miraclewhite-tech/armdojo-hardware/software/README.md

# Software (coming soon)

We are writing the control code for the ArmDojo 5-axis arm on our own assembled arm. It will be published here, with its own open-source license.

Join the discussion on [Discord](https://discord.gg/MdyRuJVFAm) in the `#software-control` channel.
