miraclewhite-tech/armdojo-hardware/arm-r5b/images/renders/hero_01_reach_camera.jpg

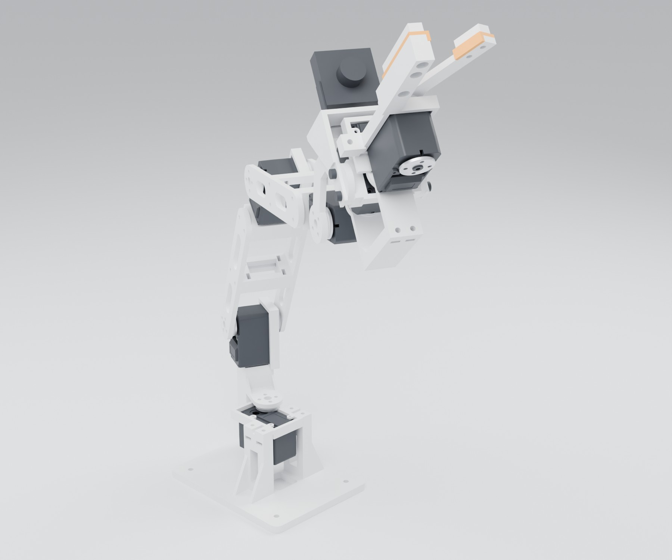
arm-r5b/images/renders/hero_01_reach_camera.jpg
