miraclewhite-tech/armdojo-hardware/arm-r5b/images/renders/hero_03_upright_side.jpg

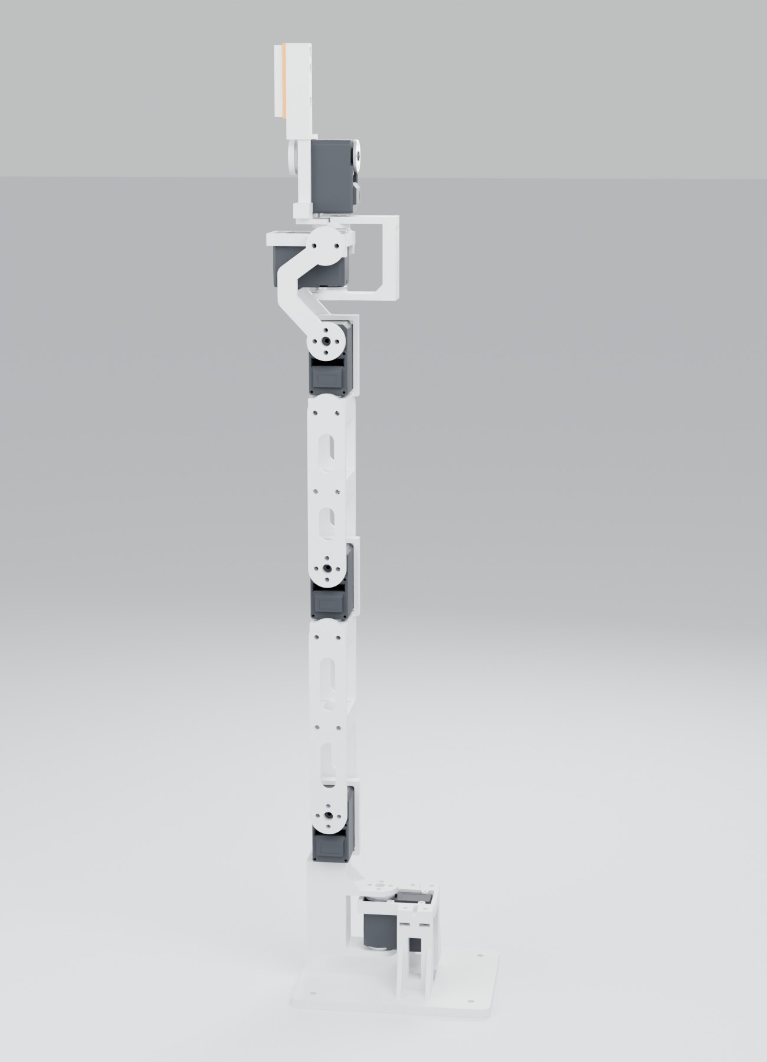
arm-r5b/images/renders/hero_03_upright_side.jpg
