miraclewhite-tech/armdojo-hardware/arm-r5b/images/renders/hero_04_folded.jpg

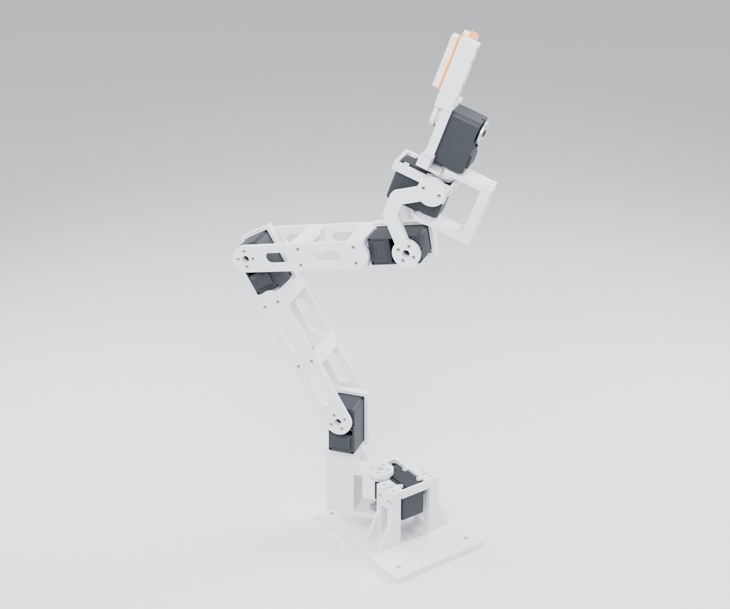
arm-r5b/images/renders/hero_04_folded.jpg
