miraclewhite-tech/armdojo-hardware/arm-r5b/print-profile/ArmDojo_5axis_arm_A1_0.4mm_PLA_TPU.3mf

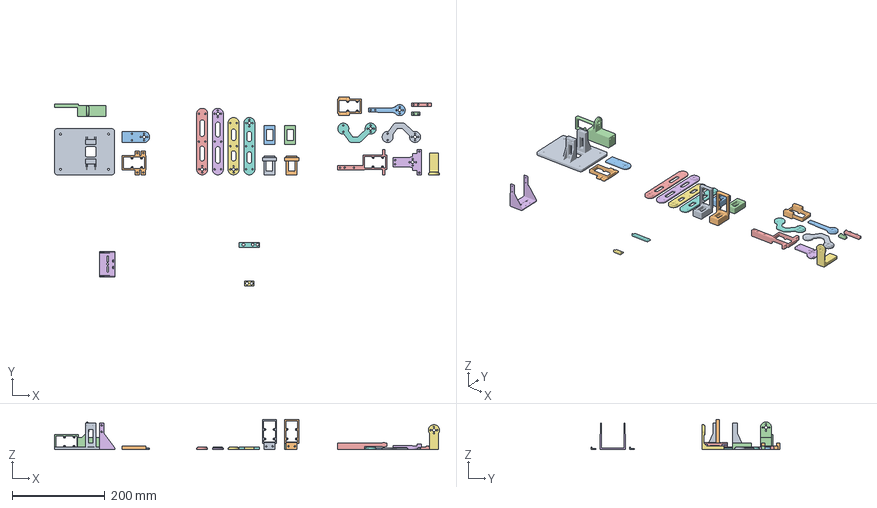
[picture p11: CAD file, 2026-10-11]
arm-r5b/print-profile/ArmDojo_5axis_arm_A1_0.4mm_PLA_TPU.3mf
832.4 x 409.1 x 65.3 mm
AD10_Base_Stand_R2
AD11_Output_Case_Cap_R2
AD13_Lower_Yaw_Arm_R2
AD12_Shoulder_Carrier_R3
AD14_Upper_Arm_Drive_R3
AD15_Upper_Arm_Rear_R3
AD18_Forearm_Drive_R4
AD19_Forearm_Rear_R4
AD17_Elbow_Carrier_R4
AD20_Wrist_Pitch_Carrier_R5
AD16_Cross_Brace_R3 #1
AD16_Cross_Brace_R3 #2
AD24_Gripper_Cartridge_R5B
AD31_Roll_Drive_Adapter_R5B
AD32_Roll_Rear_C_Yoke_R5B
AD21_Wrist_Pitch_Drive_R5B
AD22_Wrist_Pitch_Rear_R5B
AD23_Wrist_Roll_Case_R5
AD25_Gripper_Moving_Jaw_R5B
AD29_Moving_Pad_Keeper_R5B
AD30_Fixed_Pad_Keeper_R5B
AD28_ID5_Camera_Platform_R6
AD26_Moving_Pad_TPU_R5B
AD27_Fixed_Pad_TPU_R5B
