miraclewhite-tech/armdojo-hardware/arm-r5b/step/AD29_Moving_Pad_Keeper_R5B_print.step

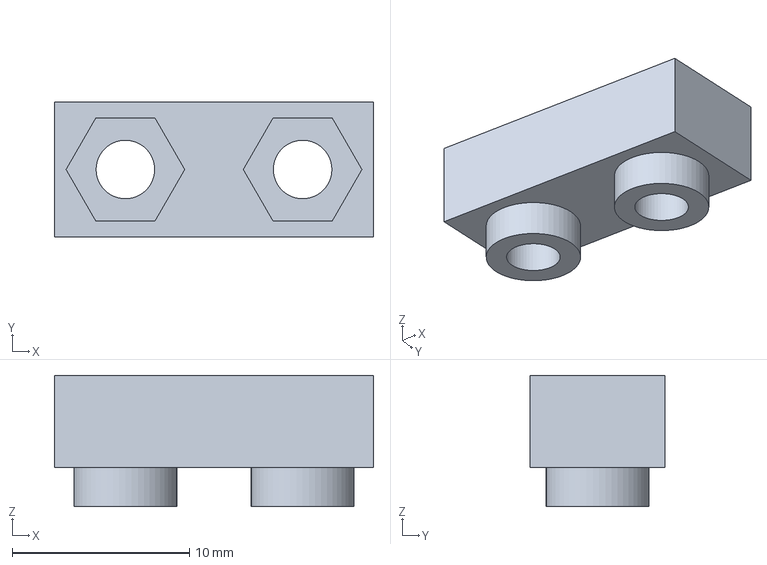
[picture p12: CAD file, 2026-10-11]
arm-r5b/step/AD29_Moving_Pad_Keeper_R5B_print.step
18.0 x 7.60 x 7.40 mm
