miraclewhite-tech/armdojo-hardware/arm-r5b/stl/AD20_Wrist_Pitch_Carrier_R5.stl

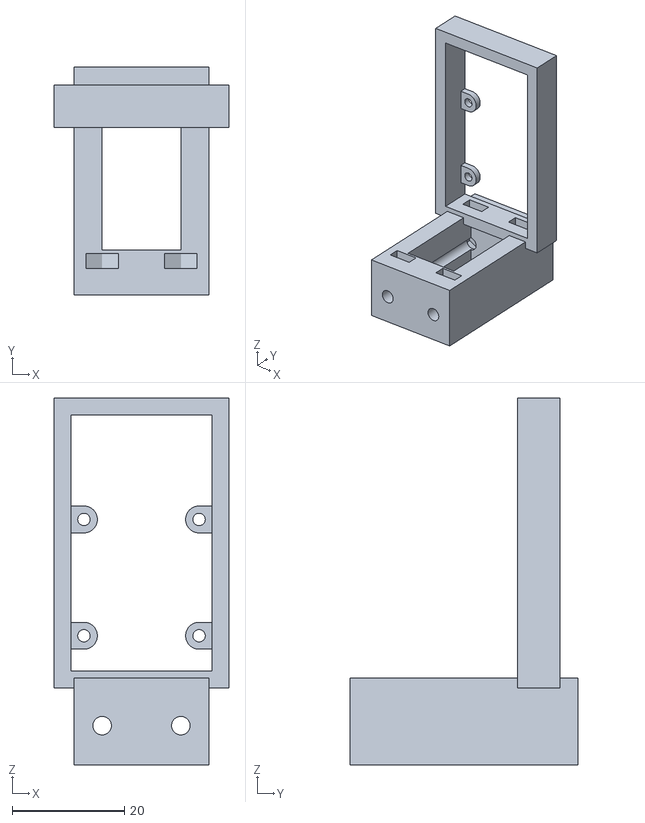
[picture p13: CAD file, 2026-10-11]
arm-r5b/stl/AD20_Wrist_Pitch_Carrier_R5.stl
31.1 x 40.6 x 65.3
