miraclewhite-tech/armdojo-hardware/arm-r5b/step/AD26_Moving_Pad_TPU_R5B_print.step

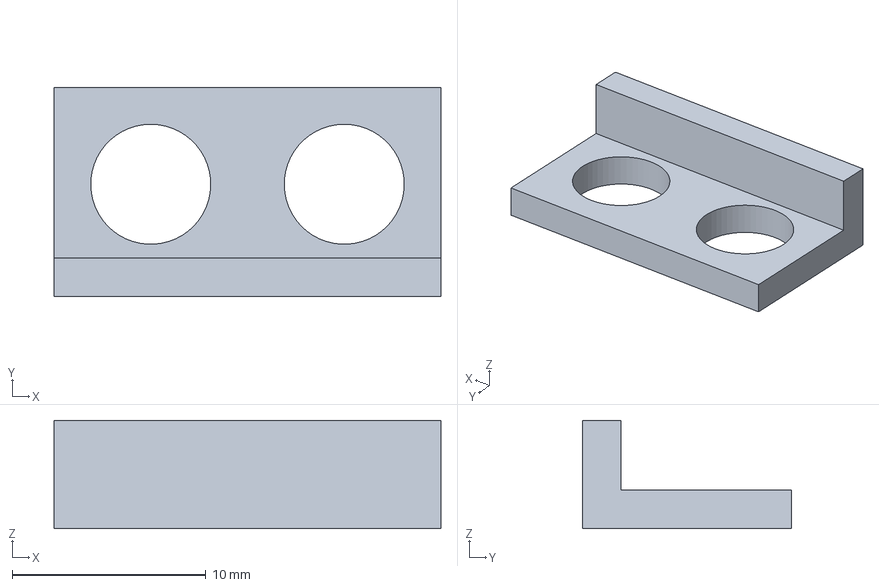
[picture p14: CAD file, 2026-10-11]
arm-r5b/step/AD26_Moving_Pad_TPU_R5B_print.step
20.0 x 10.8 x 5.60 mm
