miraclewhite-tech/armdojo-hardware/arm-r5b/stl/AD12_Shoulder_Carrier_R3.stl

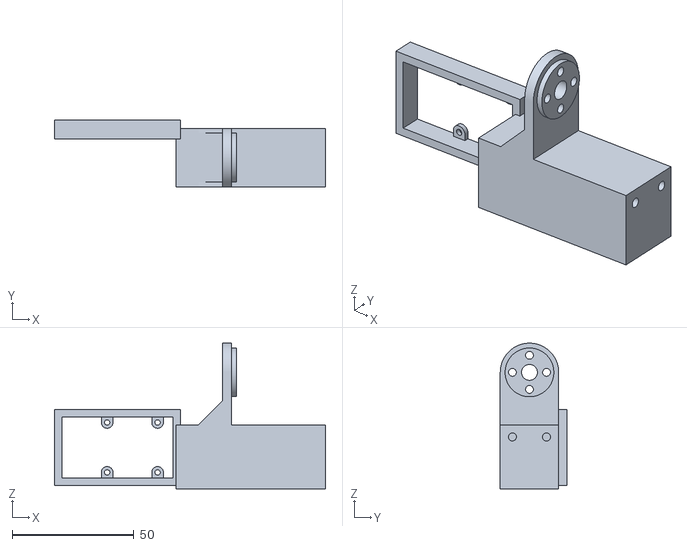
[picture p15: CAD file, 2026-10-11]
arm-r5b/stl/AD12_Shoulder_Carrier_R3.stl
111.2 x 27.3 x 59.8
