miraclewhite-tech/armdojo-hardware/arm-r5b/step/AD21_Wrist_Pitch_Drive_R5B_print.step

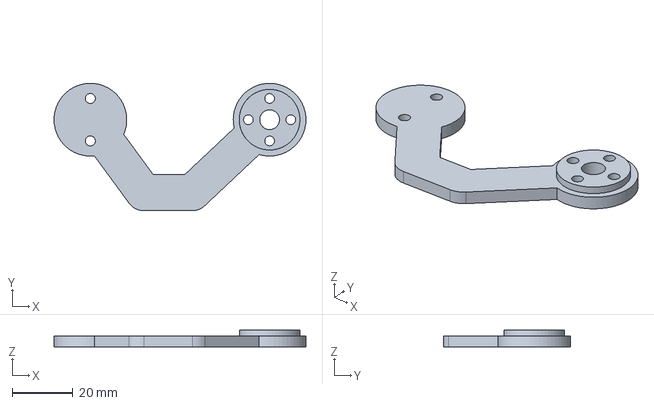
[picture p16: CAD file, 2026-10-11]
arm-r5b/step/AD21_Wrist_Pitch_Drive_R5B_print.step
83.1 x 42.0 x 5.60 mm
