miraclewhite-tech/armdojo-hardware/arm-r5b/stl/AD22_Wrist_Pitch_Rear_R5B.stl

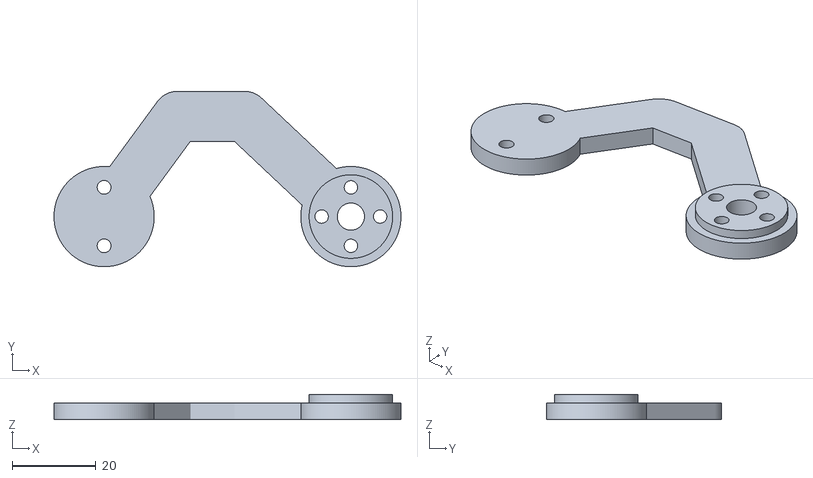
[picture p17: CAD file, 2026-10-11]
arm-r5b/stl/AD22_Wrist_Pitch_Rear_R5B.stl
83.1 x 42.0 x 6.00
