miraclewhite-tech/armdojo-hardware/arm-r5b/step/AD16_Cross_Brace_R3_print.step

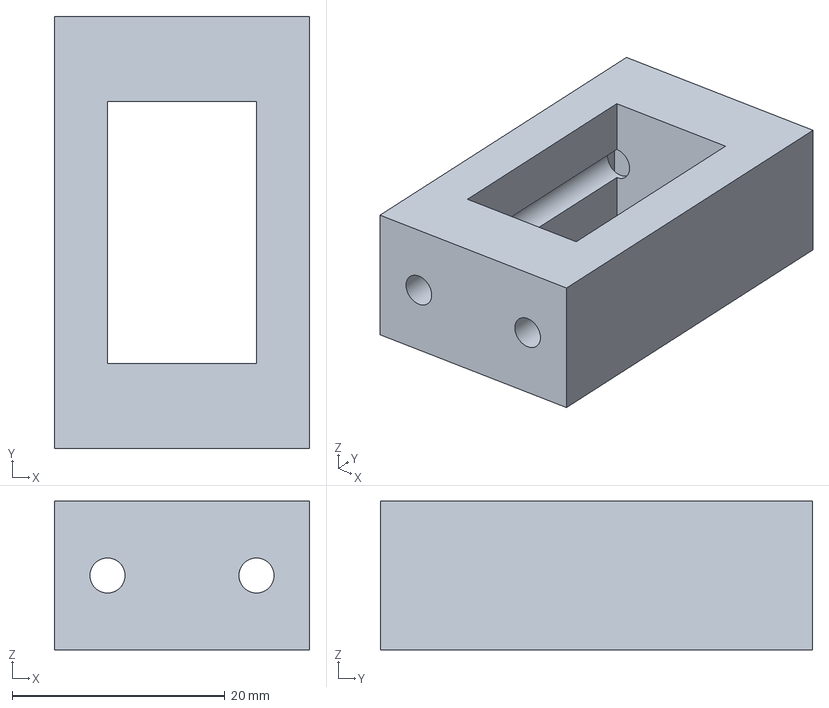
[picture p18: CAD file, 2026-10-11]
arm-r5b/step/AD16_Cross_Brace_R3_print.step
24.0 x 40.6 x 14.0 mm
