miraclewhite-tech/armdojo-hardware/arm-r5b/stl/AD32_Roll_Rear_C_Yoke_R5B.stl

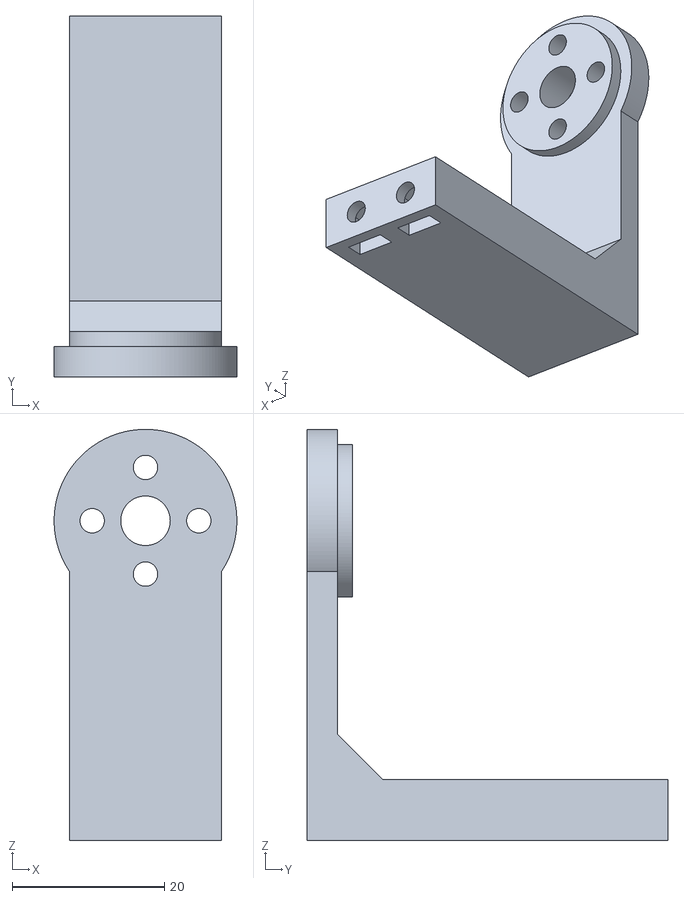
[picture p19: CAD file, 2026-10-11]
arm-r5b/stl/AD32_Roll_Rear_C_Yoke_R5B.stl
24.0 x 47.4 x 54.0
