miraclewhite-tech/armdojo-hardware/arm-r5b/stl/AD15_Upper_Arm_Rear_R3.stl

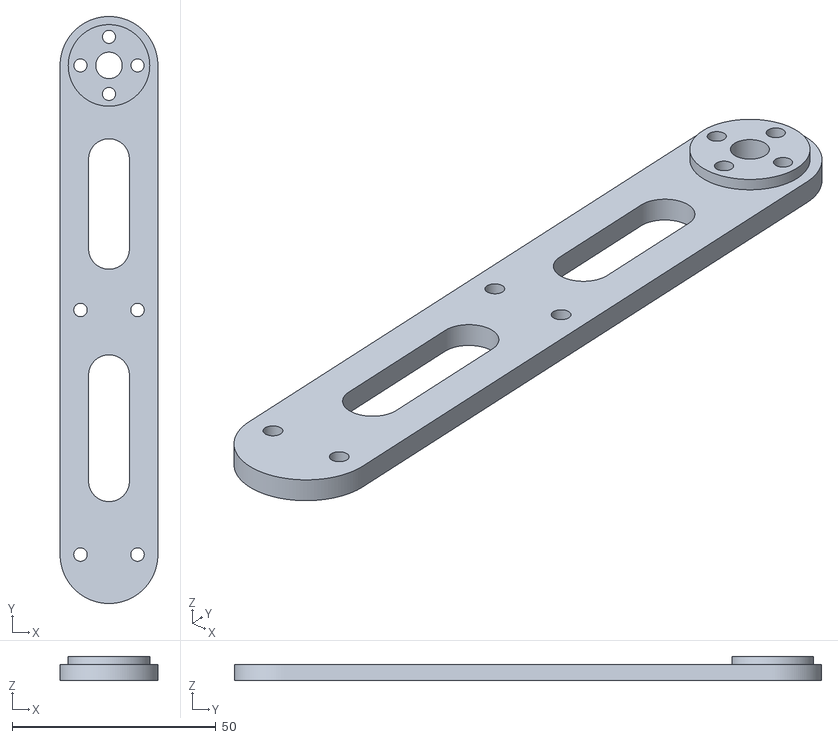
[picture p20: CAD file, 2026-10-11]
arm-r5b/stl/AD15_Upper_Arm_Rear_R3.stl
24.0 x 144.0 x 6.00
