miraclewhite-tech/armdojo-hardware/arm-r5b/stl/AD19_Forearm_Rear_R4.stl

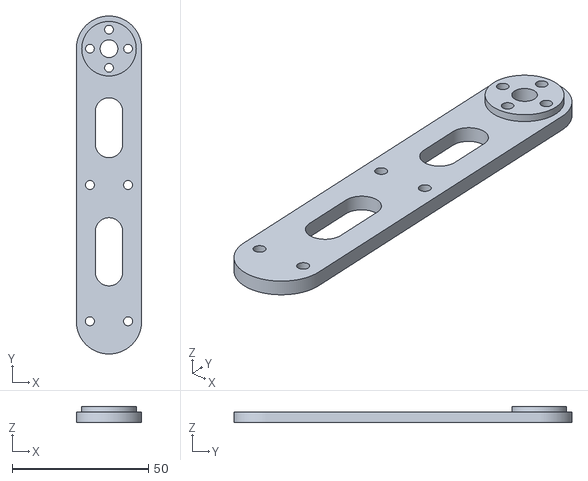
[picture p22: CAD file, 2026-10-11]
arm-r5b/stl/AD19_Forearm_Rear_R4.stl
24.0 x 124.0 x 6.00
