miraclewhite-tech/armdojo-hardware/arm-r5b/step/AD25_Gripper_Moving_Jaw_R5B_print.step

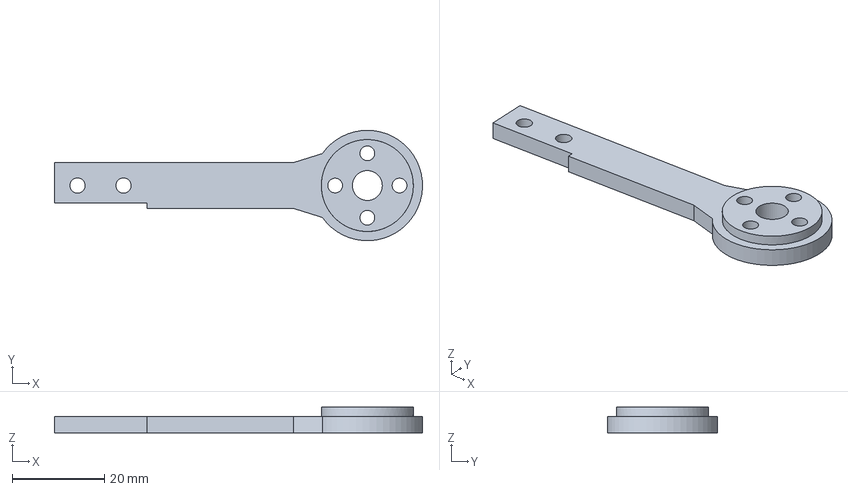
[picture p23: CAD file, 2026-10-11]
arm-r5b/step/AD25_Gripper_Moving_Jaw_R5B_print.step
80.0 x 24.0 x 5.60 mm
