miraclewhite-tech/armdojo-hardware/arm-r5b/step/AD23_Wrist_Roll_Case_R5_print.step

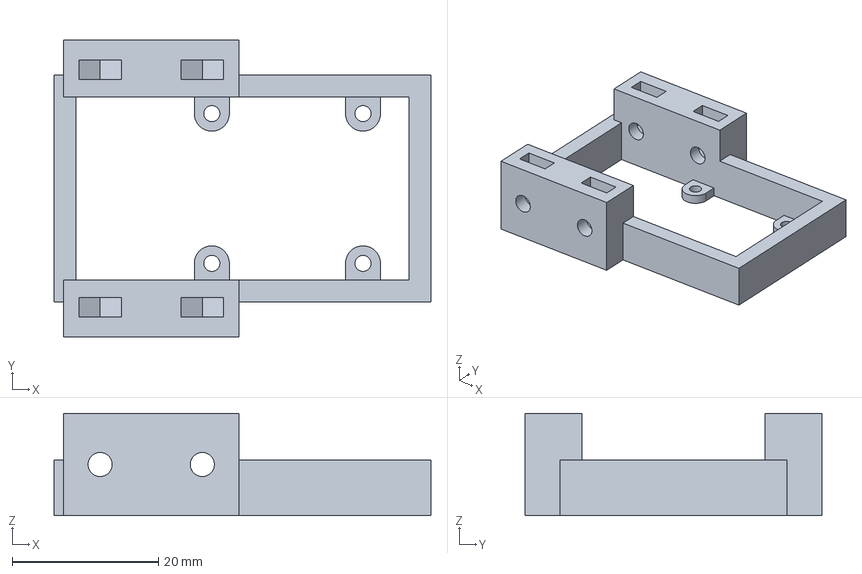
[picture p24: CAD file, 2026-10-11]
arm-r5b/step/AD23_Wrist_Roll_Case_R5_print.step
51.6 x 40.6 x 14.0 mm
