miraclewhite-tech/armdojo-hardware/arm-r5b/stl/AD18_Forearm_Drive_R4.stl

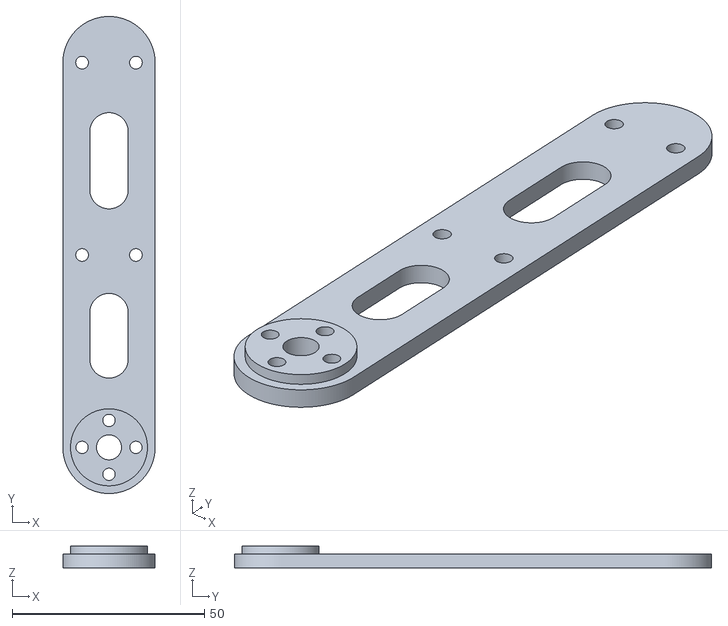
[picture p25: CAD file, 2026-10-11]
arm-r5b/stl/AD18_Forearm_Drive_R4.stl
24.0 x 124.0 x 5.60
