miraclewhite-tech/armdojo-hardware/arm-r5b/step/AD31_Roll_Drive_Adapter_R5B_print.step

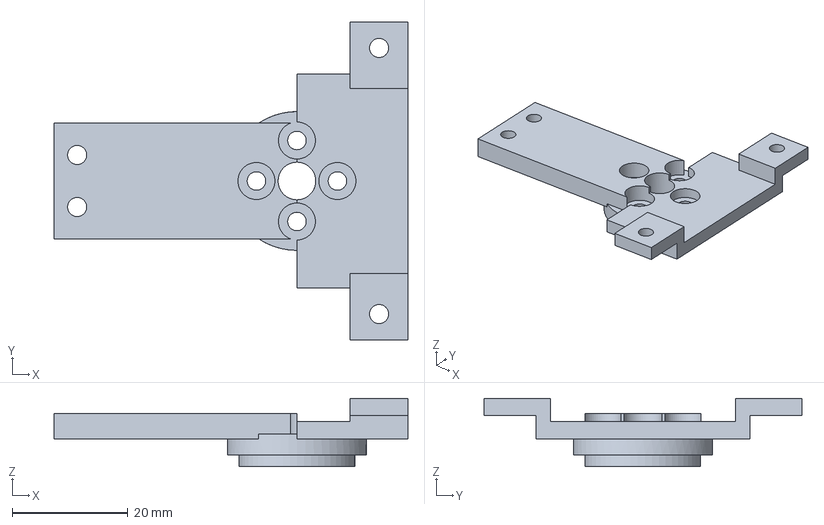
[picture p26: CAD file, 2026-10-11]
arm-r5b/step/AD31_Roll_Drive_Adapter_R5B_print.step
61.2 x 55.0 x 11.8 mm
