miraclewhite-tech/armdojo-hardware/arm-r5b/stl/AD11_Output_Case_Cap_R2.stl

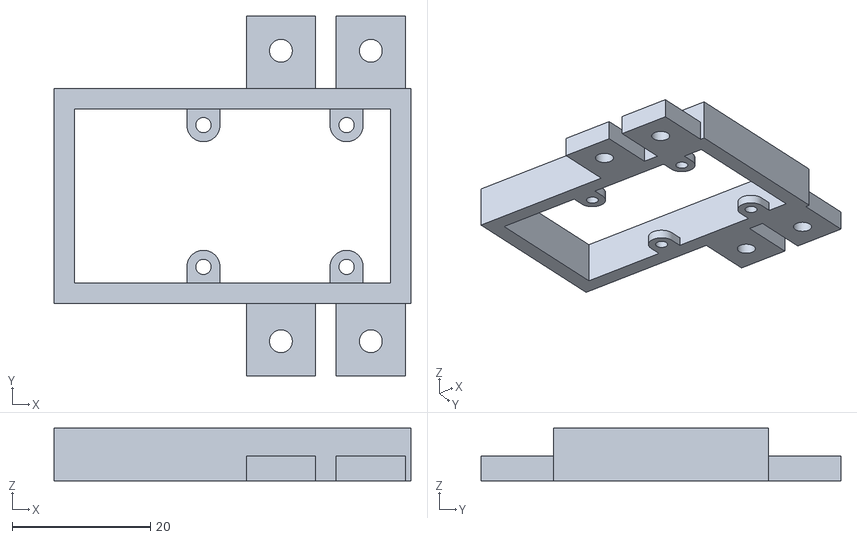
[picture p27: CAD file, 2026-10-11]
arm-r5b/stl/AD11_Output_Case_Cap_R2.stl
51.6 x 52.0 x 7.60
