miraclewhite-tech/armdojo-hardware/arm-r5b/step/AD13_Lower_Yaw_Arm_R2_print.step

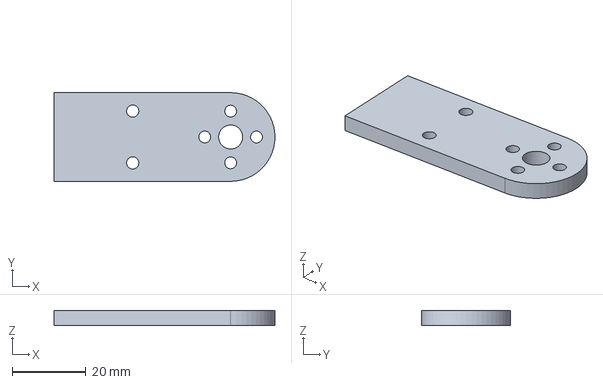
[picture p28: CAD file, 2026-10-11]
arm-r5b/step/AD13_Lower_Yaw_Arm_R2_print.step
59.8 x 24.0 x 4.00 mm
