miraclewhite-tech/armdojo-hardware/arm-r5b/step/AD14_Upper_Arm_Drive_R3_print.step

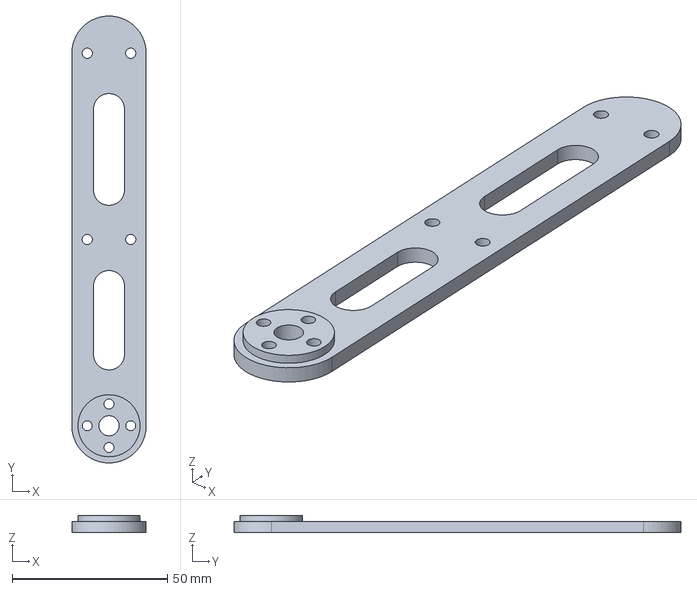
[picture p29: CAD file, 2026-10-11]
arm-r5b/step/AD14_Upper_Arm_Drive_R3_print.step
24.0 x 144.0 x 5.60 mm
