miraclewhite-tech/armdojo-hardware/arm-r5b/stl/AD10_Base_Stand_R2.stl

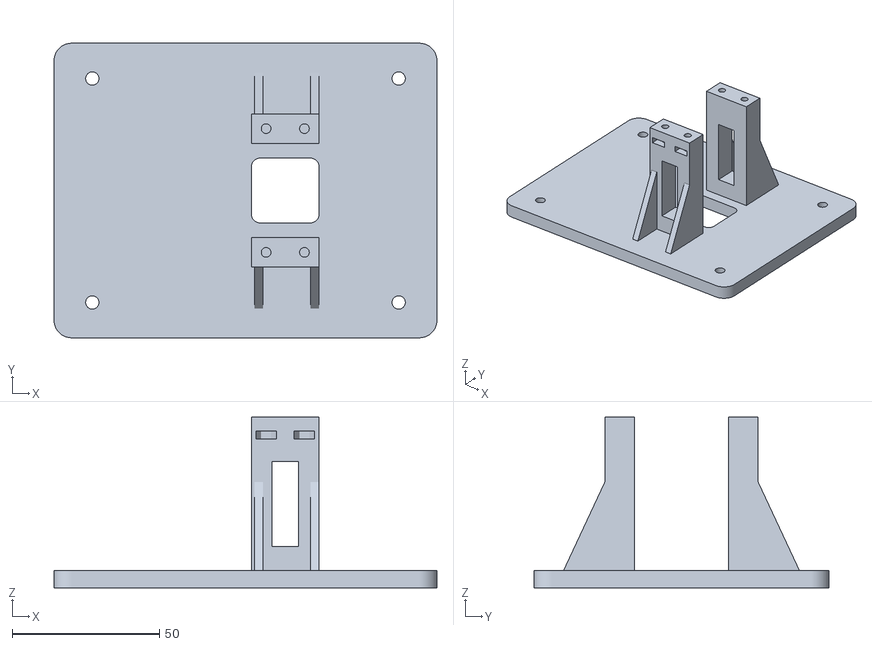
[picture p30: CAD file, 2026-10-11]
arm-r5b/stl/AD10_Base_Stand_R2.stl
130.0 x 100.0 x 58.0
