miraclewhite-tech/armdojo-hardware/arm-r5b/stl/AD27_Fixed_Pad_TPU_R5B.stl

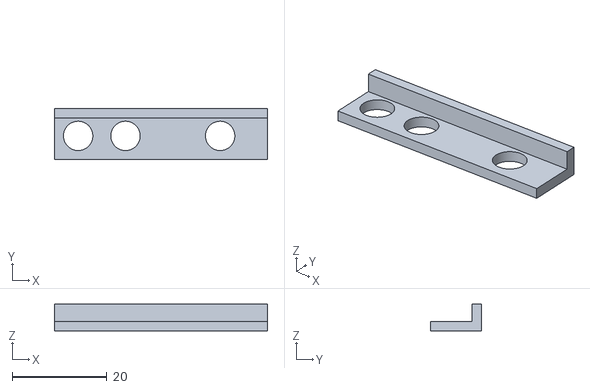
[picture p31: CAD file, 2026-10-11]
arm-r5b/stl/AD27_Fixed_Pad_TPU_R5B.stl
45.0 x 10.8 x 5.60
