miraclewhite-tech/armdojo-hardware/arm-r5b/step/AD28_ID5_Camera_Platform_R6_print.step

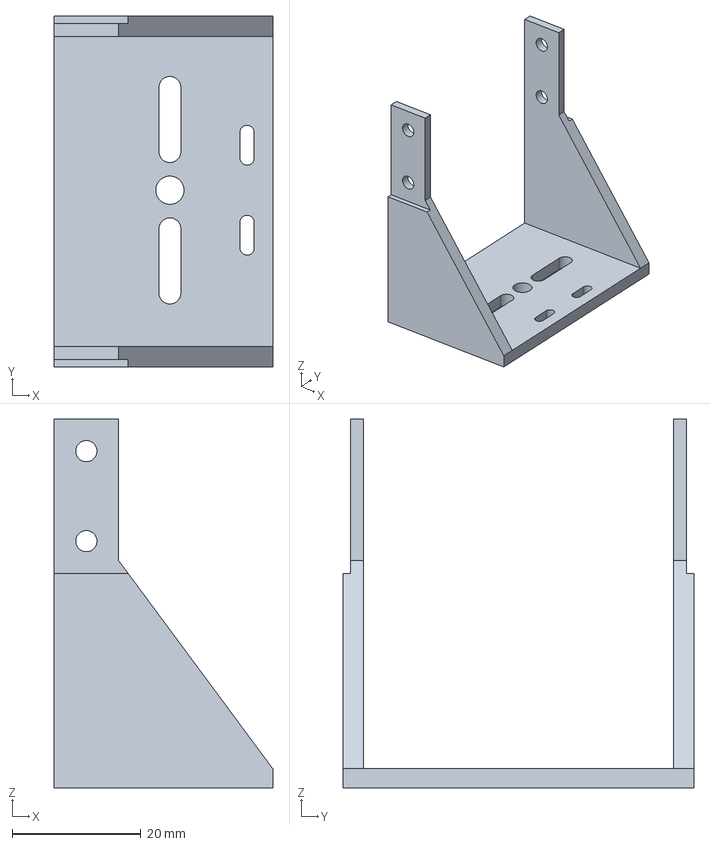
[picture p32: CAD file, 2026-10-11]
arm-r5b/step/AD28_ID5_Camera_Platform_R6_print.step
34.0 x 54.6 x 57.4 mm
