miraclewhite-tech/armdojo-hardware/arm-r5b/step/AD24_Gripper_Cartridge_R5B_print.step

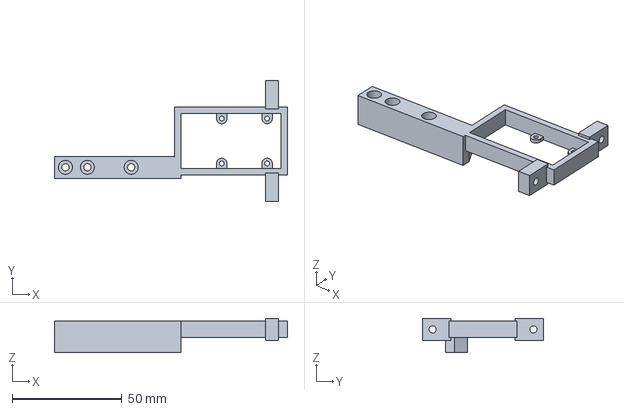
[picture p33: CAD file, 2026-10-11]
arm-r5b/step/AD24_Gripper_Cartridge_R5B_print.step
106.3 x 55.0 x 15.6 mm
