miraclewhite-tech/armdojo-hardware/(list of files, cad)

Other CAD files:
arm-r5b/step/AD20_Wrist_Pitch_Carrier_R5_print.step
arm-r5b/stl/AD16_Cross_Brace_R3.stl
arm-r5b/step/AD15_Upper_Arm_Rear_R3_print.step
arm-r5b/stl/AD26_Moving_Pad_TPU_R5B.stl
arm-r5b/step/AD22_Wrist_Pitch_Rear_R5B_print.step
arm-r5b/step/AD27_Fixed_Pad_TPU_R5B_print.step
arm-r5b/stl/AD14_Upper_Arm_Drive_R3.stl
arm-r5b/stl/AD29_Moving_Pad_Keeper_R5B.stl
arm-r5b/step/AD10_Base_Stand_R2_print.step
arm-r5b/stl/AD30_Fixed_Pad_Keeper_R5B.stl
arm-r5b/step/AD32_Roll_Rear_C_Yoke_R5B_print.step
arm-r5b/stl/AD13_Lower_Yaw_Arm_R2.stl
arm-r5b/step/AD18_Forearm_Drive_R4_print.step
arm-r5b/stl/AD23_Wrist_Roll_Case_R5.stl
arm-r5b/stl/AD21_Wrist_Pitch_Drive_R5B.stl
arm-r5b/step/AD11_Output_Case_Cap_R2_print.step
arm-r5b/stl/AD25_Gripper_Moving_Jaw_R5B.stl
arm-r5b/step/AD17_Elbow_Carrier_R4_print.step
arm-r5b/stl/AD24_Gripper_Cartridge_R5B.stl
arm-r5b/step/AD12_Shoulder_Carrier_R3_print.step
arm-r5b/stl/AD31_Roll_Drive_Adapter_R5B.stl
arm-r5b/step/AD19_Forearm_Rear_R4_print.step
arm-r5b/stl/AD28_ID5_Camera_Platform_R6.stl
