miraclewhite-tech/armdojo-hardware/arm-r5b/images/assembly/step02_shoulder_upper_arm.jpg

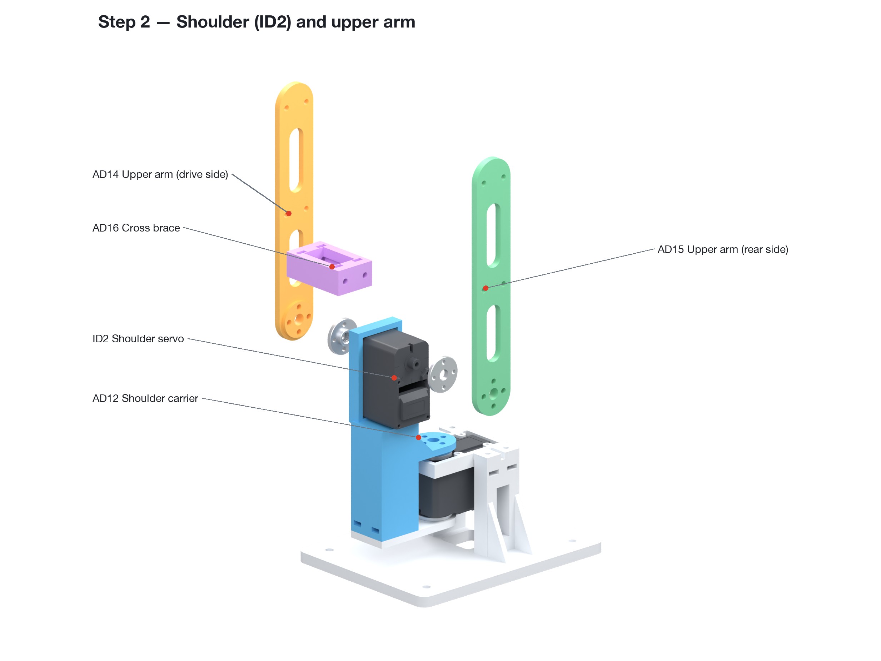
arm-r5b/images/assembly/step02_shoulder_upper_arm.jpg
