miraclewhite-tech/armdojo-hardware/arm-r5b/images/assembly/step03_elbow_forearm.jpg

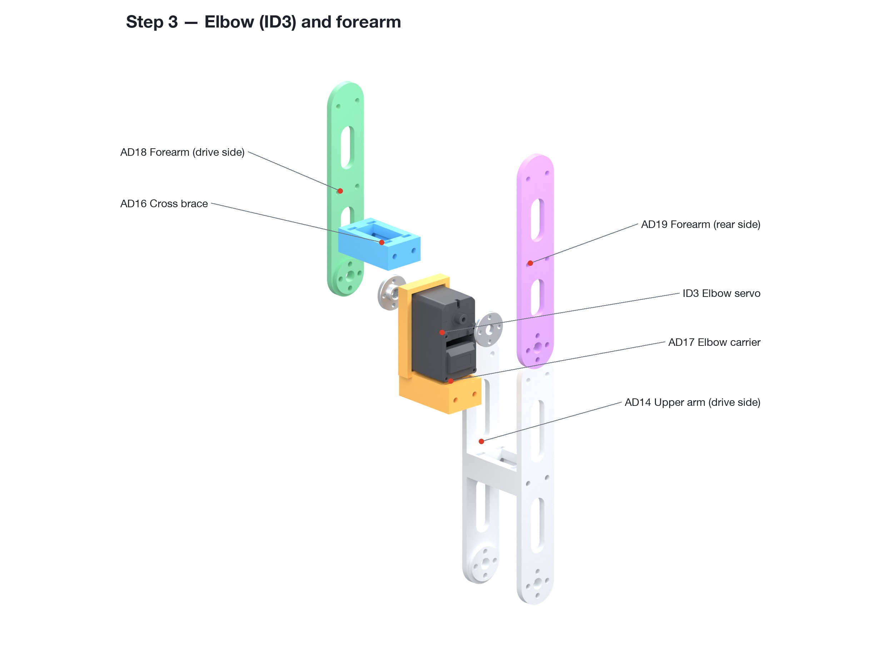
arm-r5b/images/assembly/step03_elbow_forearm.jpg
