miraclewhite-tech/armdojo-hardware/arm-r5b/images/assembly/step04_wrist_pitch.jpg

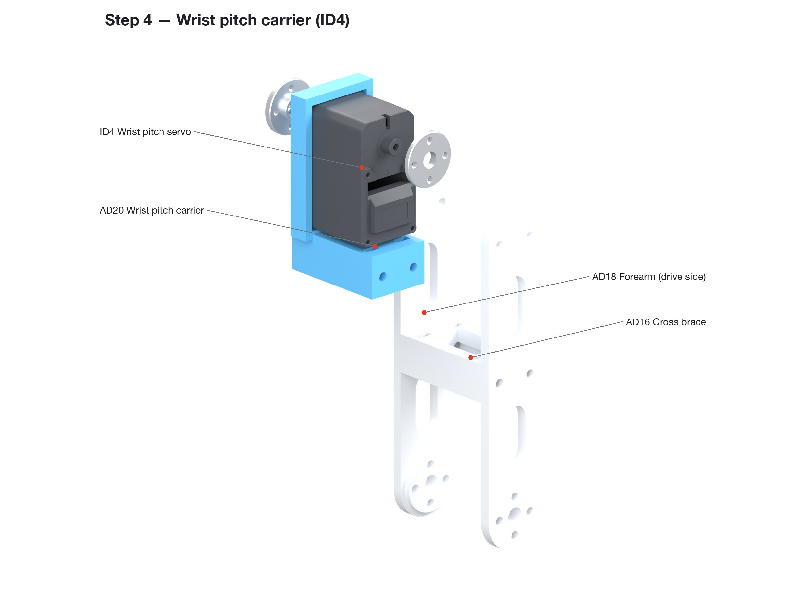
arm-r5b/images/assembly/step04_wrist_pitch.jpg
