miraclewhite-tech/armdojo-hardware/arm-r5b/images/assembly/step06_side_plates.jpg

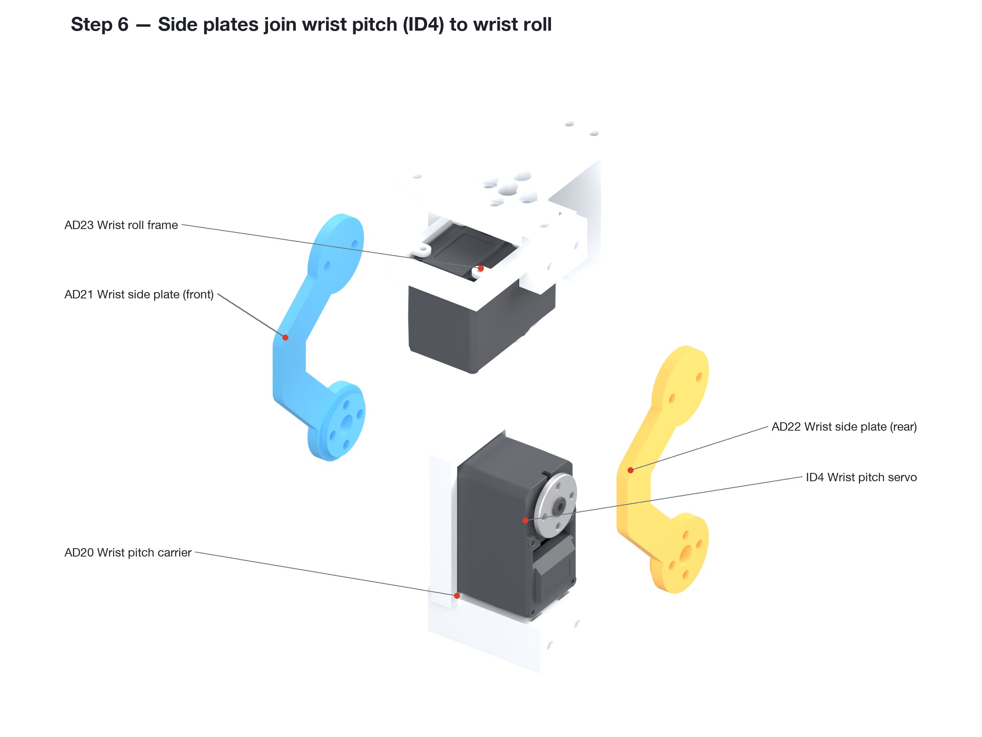
arm-r5b/images/assembly/step06_side_plates.jpg
