miraclewhite-tech/armdojo-hardware/arm-r5b/images/assembly/step07_pads.jpg

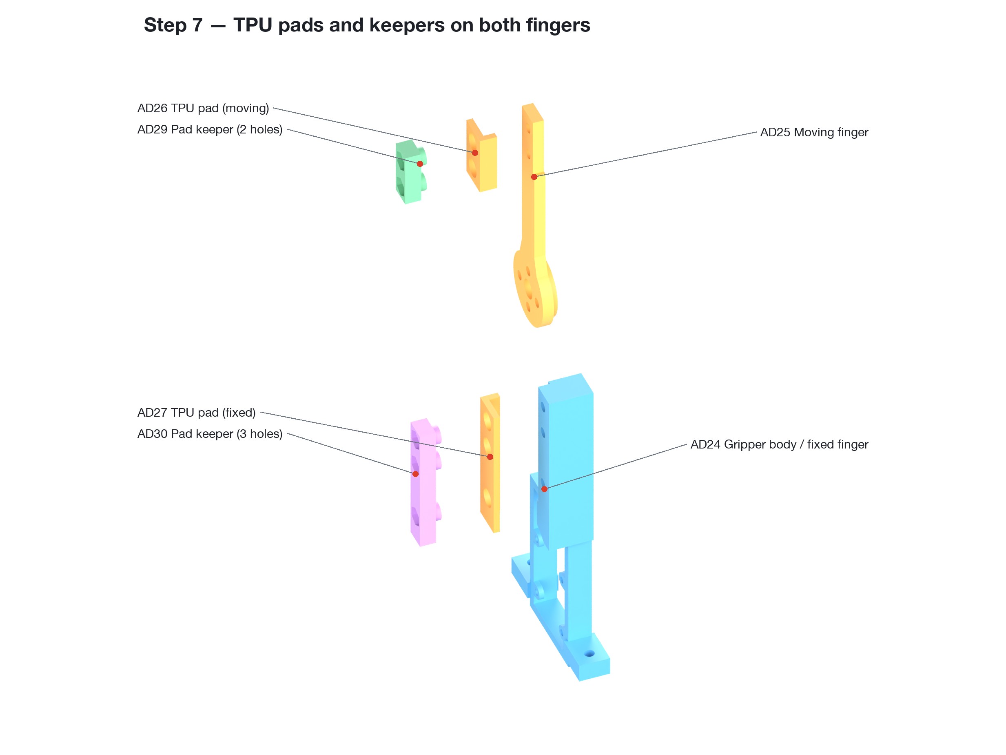
arm-r5b/images/assembly/step07_pads.jpg
