miraclewhite-tech/armdojo-hardware/arm-r5b/images/assembly/step08_gripper_servo.jpg

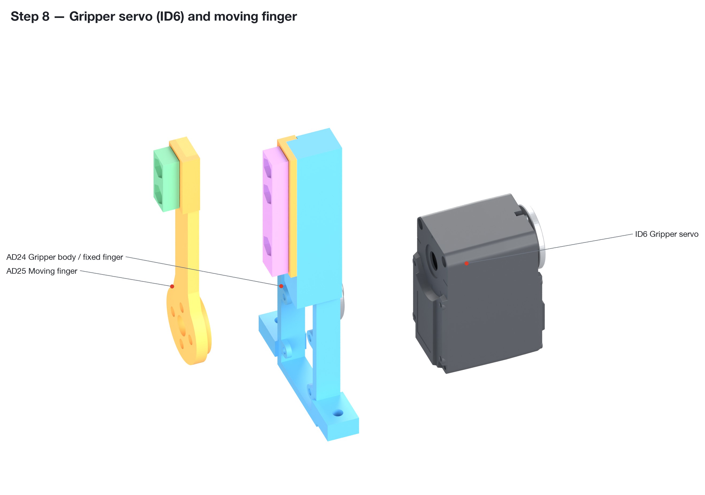
arm-r5b/images/assembly/step08_gripper_servo.jpg
