miraclewhite-tech/armdojo-hardware/arm-r5b/images/assembly/step09_mount_gripper.jpg

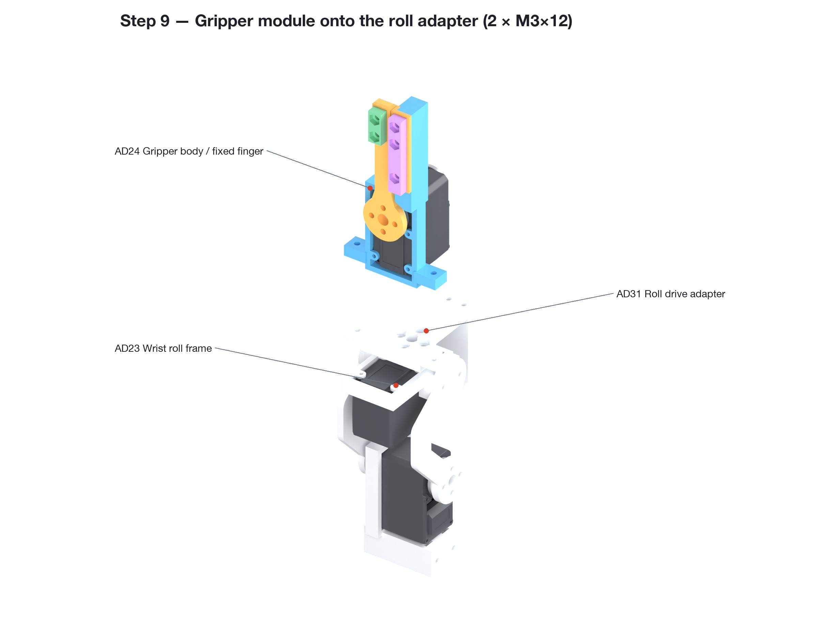
arm-r5b/images/assembly/step09_mount_gripper.jpg
