miraclewhite-tech/armdojo-hardware/arm-r5b/images/assembly/step10_camera.jpg

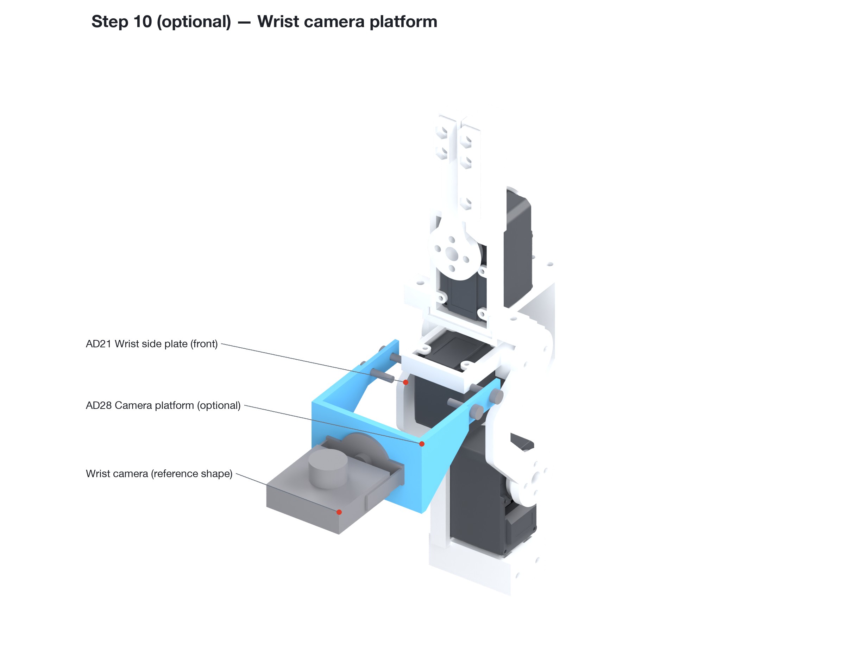
arm-r5b/images/assembly/step10_camera.jpg
