miraclewhite-tech/armdojo-hardware/arm-r5b/print-profile/plate_1.png

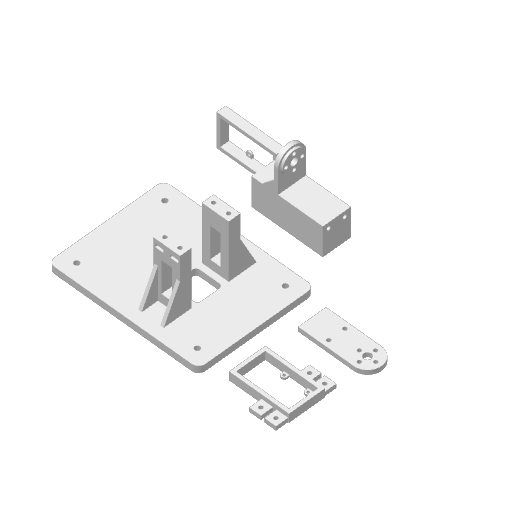
arm-r5b/print-profile/plate_1.png
