miraclewhite-tech/armdojo-hardware/arm-r5b/print-profile/plate_2.png

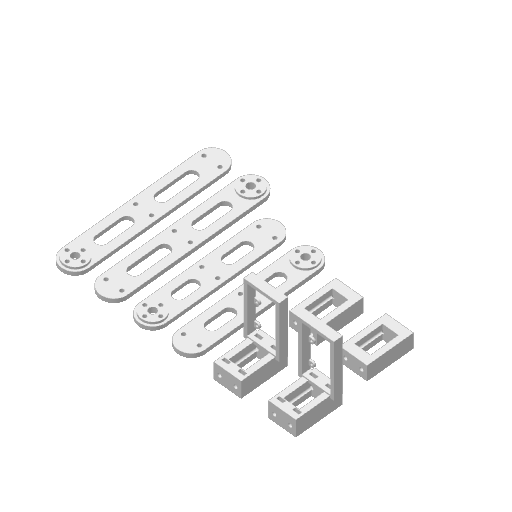
arm-r5b/print-profile/plate_2.png
