miraclewhite-tech/armdojo-hardware/arm-r5b/print-profile/plate_3.png

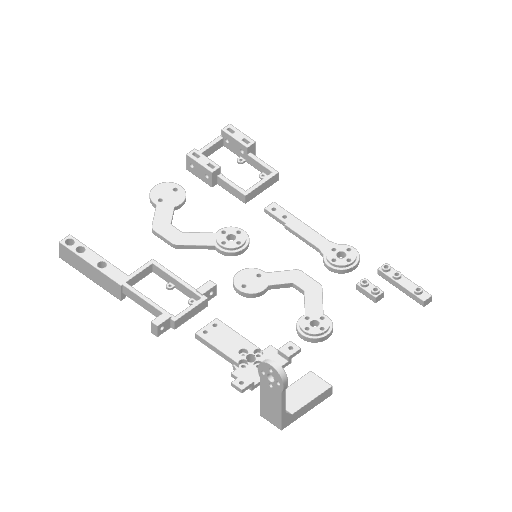
arm-r5b/print-profile/plate_3.png
