miraclewhite-tech/armdojo-hardware/arm-r5b/print-profile/plate_4.png

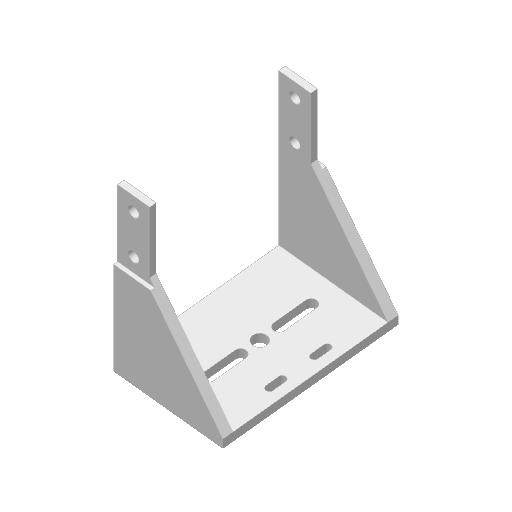
arm-r5b/print-profile/plate_4.png
