miraclewhite-tech/armdojo-hardware/arm-r5b/print-profile/plate_5.png

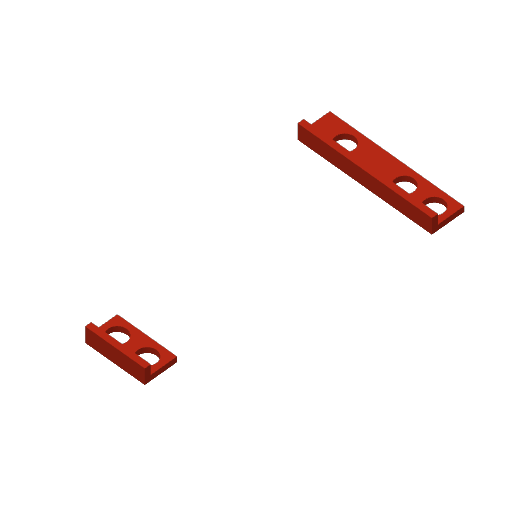
arm-r5b/print-profile/plate_5.png
